facecjf/PiSDR/docs/images/enclosure_exploded.png

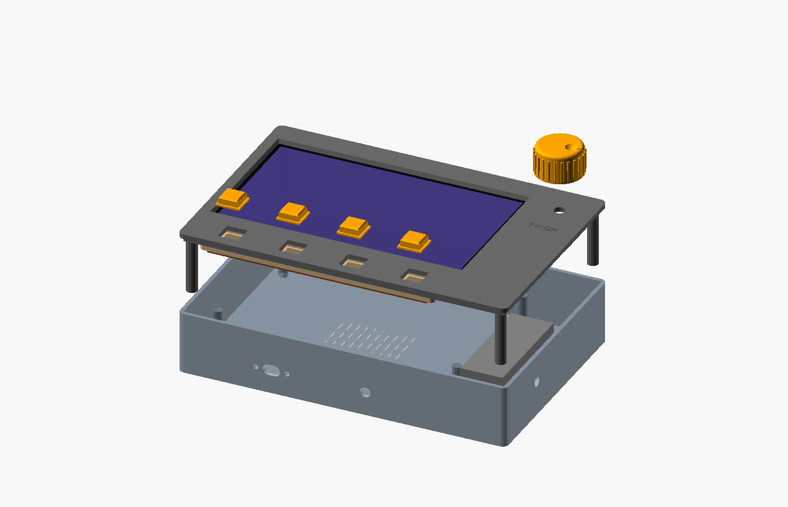
docs/images/enclosure_exploded.png
