facecjf/PiSDR/docs/images/rear_shell_inside.png

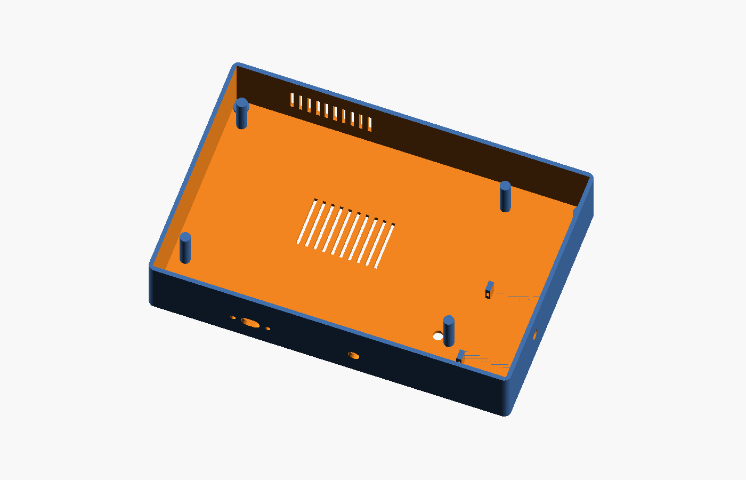
docs/images/rear_shell_inside.png
