facecjf/PiSDR/Original/pi_sdr_gpio_pinout.png

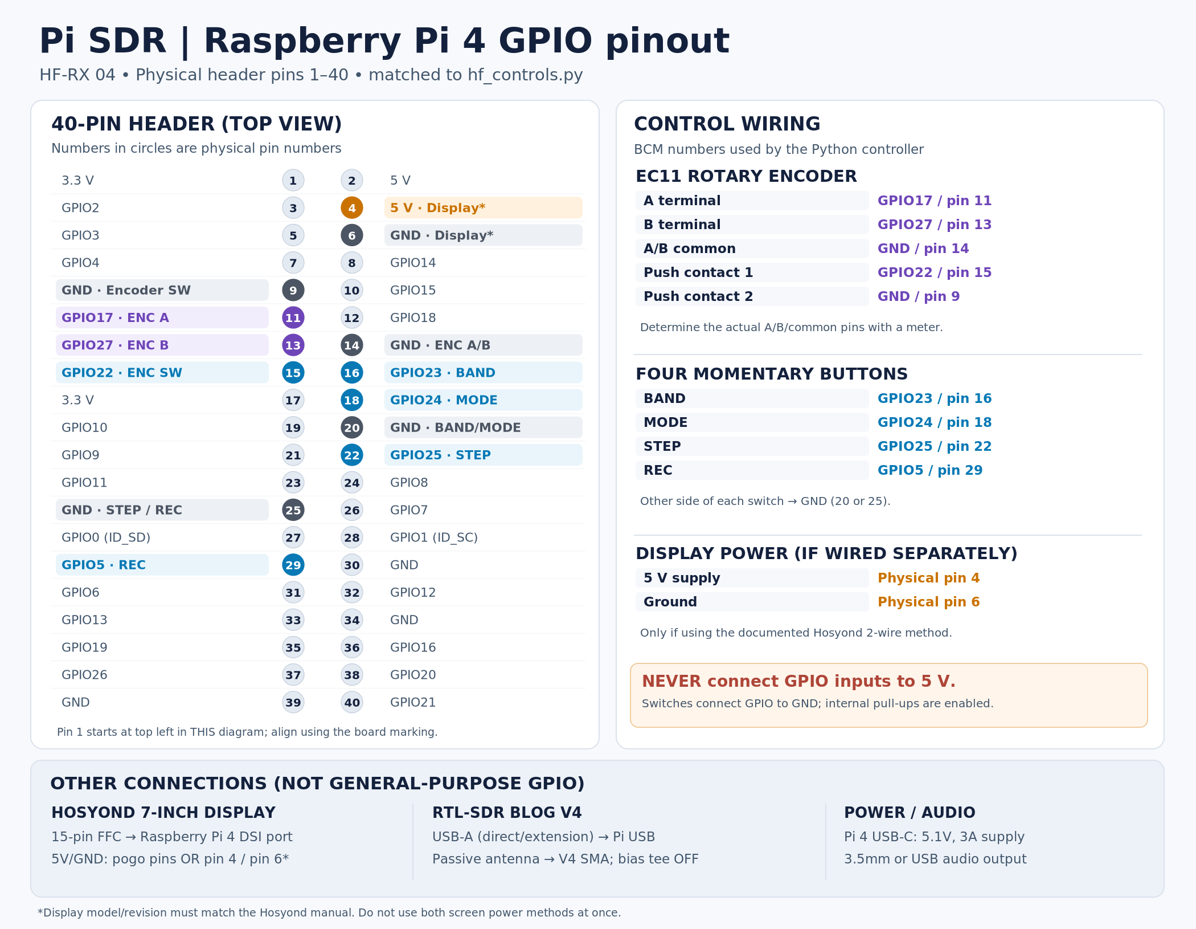
Original/pi_sdr_gpio_pinout.png
