facecjf/PiSDR/cad/pisdr_assembly.3mf

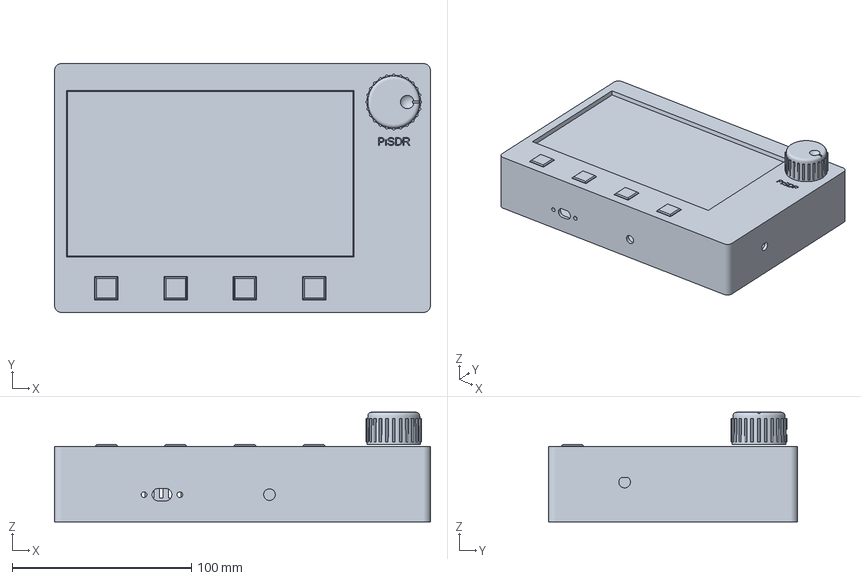
[picture p15: CAD file, 2026-10-27]
cad/pisdr_assembly.3mf
209.9 x 139.0 x 61.1 mm
