facecjf/PiSDR/cad/pisdr_3dprint.3mf

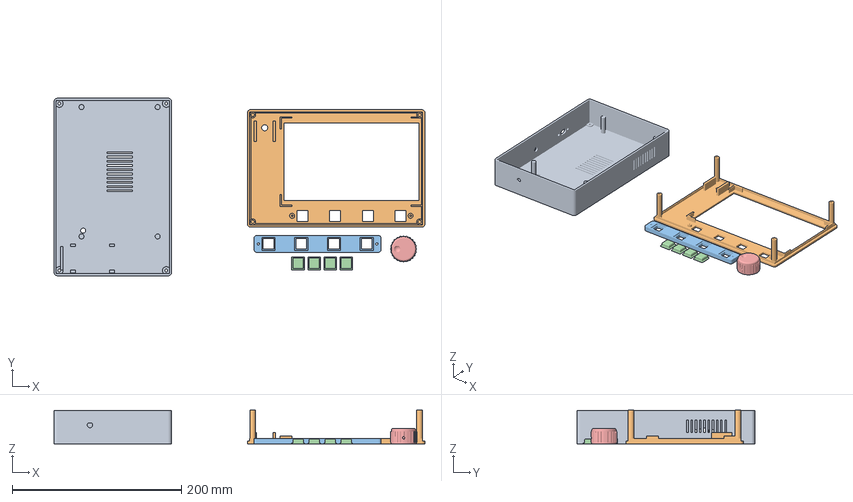
[picture p16: CAD file, 2026-10-27]
cad/pisdr_3dprint.3mf
438.4 x 209.9 x 39.7 mm
pisdr_rear.stl
pisdr_front.stl
pisdr_carrier.stl
pisdr_keycaps.stl
pisdr_knob.stl
