facecjf/PiSDR/(commit log)

2026-10-27 Initial commit of the Pi 4 RTL-SDR receiver, including the touch UI, enclosure, and build docs.
    [pisdr_3dprint.3mf, pisdr_assembly.3mf, pisdr_assembly.scad, pisdr_carrier.scad, pisdr_coupon.scad, pisdr_front.scad, pisdr_keycaps.scad, pisdr_knob.scad]
2026-11-01 Add band/memory scanning and named frequency memories.
    Also reverse encoder A/B so the rotary dial tunes the expected direction.
    [config.py, gpio.py, memories.py, scan.py, state.py]
2026-11-01 Add audio DSP, CW Morse decode, themes, and HF number-station presets.
    Also rework Settings into a two-column layout, fix band-page clipping, and keep the audio path C++-only unless NR/NB are enabled.
    [config.py]
2026-11-11 Add settings tabs, decoders, RDS, network mode and a richer spectrum display.
    - Tabbed Settings (RADIO/AUDIO/DISPLAY/SCAN/SYSTEM) exposing filter width per mode,
    PPM, S-meter calibration, CW pitch, brightness/dimming, UTC clock, knob acceleration,
    scan timing, priority channel, lockouts and a scan log.
    - Memory groups and schedules, record timer and a recordings browser.
    - RDS on FM broadcast (gr-rds), multimon-ng data decoders (APRS, POCSAG, FLEX, EAS,
    DTMF) and an rtl_tcp network mode.
    - CW decoder reads the pre-AGC signal with an adaptive threshold, fixing garbled text.
    - Spectrum: zoom to x64 with on-screen zoom/seek buttons, filled gradient trace,
    waterfall palettes, signal mark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
    [backlight.py, config.py]
2026-11-12 Add an ADS-B aircraft map, a test suite and robustness fixes.
    ADS-B map
    - Picking the ADS-B 1090 band (or Settings > SYSTEM) lends the dongle to a dump1090
    decoder and shows a radar-style plot: range rings, coastlines and borders, aircraft
    arrows with callsign, flight level and trails, plus a list of the nearest aircraft.
    ZOOM - / ZOOM + / LABELS / BACK on the keys, the knob selects an aircraft.
    - Works with dump1090-fa, dump1090-mutability and readsb through aircraft.json on the
    RAM disk; no service and no network ports. install.sh builds dump1090 v11.1 from
    source and --check lists it.
    - Natural Earth outlines bundled as config/outlines.npz (tools/build_outlines.py).
    Robustness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
    [adsb.py, backlight.py]
2026-11-13 Lay out the main screen like piHPSDR.
    The main screen is rebuilt in piHPSDR's arrangement; the other pages keep
    their one-line status bar.
    - VFO bar: a status line (mode and filter width, AGC, NR, NB, notch, HPF,
    LPF, squelch, RDS, decoder, bias tee, REC; lit when on, grey when off)
    and a line with band, step, zoom, knob function and levels. Tapping an
    indicator goes to its control or opens Settings on that row.
    - VFO A with a second VFO B (frequency, mode and step): tap B or press
    A<>B to swap, hold A<>B to copy A to B. Tap a digit of the dial to set
    the step, hold the dial for the keypad.
    - Meter in S-units and dB with the clock and the HF conditions chip.
    - MENU opens a new pag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
    [state.py]
